yeume/skellyyeume/README.md

# **skellyyeume**
This is a guide on how to hardwire build a TBK skeletyl <br>

https://bastardkb.com/product/skeletyl-kit/
https://github.com/Bastardkb/Skeletyl/tree/main?tab=readme-ov-file

# Table of Contents
1. [Rules](#rules)
2. [Useful Links](#usefullinks)
3. [Prerequisites & things to download](#prereq)
4. [BOM (Bill of materials)](#bom)
5. [How does handwiring keyboard work?](#howthehell)
6. [What are all these files in the firmware folder?](#whatthehell)
7. [Getting the firmware onto the microcontroller](#buildfirmware)
8. [Wiring up the board](#wiring)
8. [Assembling the case](#finalassembly)
9. [Okay I wired everything, but it doesn't work...](#debug)
10. [Future...](#todo)

<br>

___

<br>

<div id='rules'>

# Rules

- NEVER unplug the TRRS jack from either half of the keyboard while it is plugged in via usb to the computer.
- ALWAYS flash the firmware to both microcontrollers when making changes.

<br>

___

<br>

<div id='usefullinks'>

# Useful Links 
https://docs.qmk.fm/features/split_keyboard<br>
https://docs.splitkb.com/troubleshooting/one-half<br>
https://docs.qmk.fm/keycodes_basic<br>
https://docs.qmk.fm/feature_layers<br>
https://docs.qmk.fm/mod_tap (if you want to use [**homerow mods**](https://precondition.github.io/home-row-mods))

<br>

___

<br>

# Disclaimer: 
- You do not need any prior programming background, but it helps.
- This guide assumes you have some experience with soldering.
- keymapping in vial is ready! check the firmware folder. 
- The default bootmagic button for putting your microcontroller in DFU mode after the first successful flash is 0,0 on each half (your Q key for the left half and Y key for the right half -- you simply need to hold the button down while connecting the half of the keyboard via usb)
- The vial secure unlock buttons are 0,0 and 0,1 (Q and W key on the keyboard)

<br>

___

<br>

<div id='prereq'>

# Prerequisites & things to download:

- It is **highly** recommended to watch Joe scotto's vid, https://youtu.be/hjml-K-pV4E?t=41&feature=shared. Yes it is 20 minutes long, but it goes over very important fundamnetals and techniques that will be useful for completing this build.

- [QMK MSYS](https://msys.qmk.fm) <details>
<collapse> </collapse>
This is the CLI (Command Line Interface, think of it like the command prompt/power shell on windows (or if you're a mac user, the terminal), but it comes with lots of prebuilt tools, and also has Git preinstalled so you don't need to go through manually setting up Git on your machine). Install it wherever you like, as long as you can find it later.
</details>

- [VS Code](https://code.visualstudio.com/download)<details>
<collapse> </collapse>
Text editor of choice, you'll use this to modify the keymap later when building the firmware.
</details>

<br>

___

<br>

<div id='bom'>

# BOM:
- Case/Plate <details>
<collapse> </collapse>
if you have a 3d printer, feel free to use the files
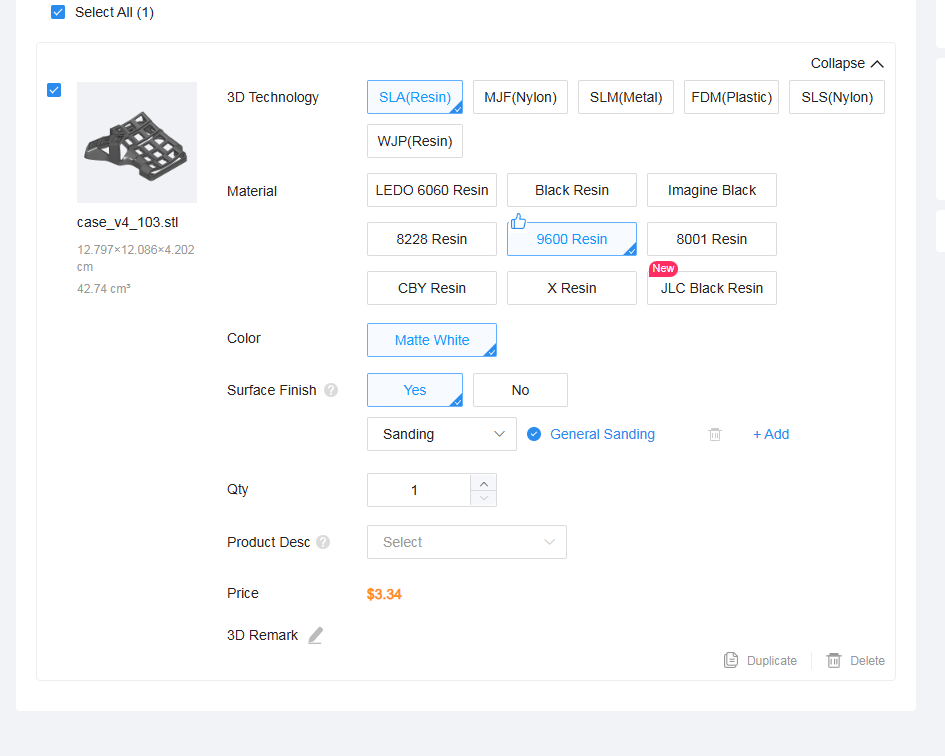
[picture p1: pictures/jlc_order_option.png]
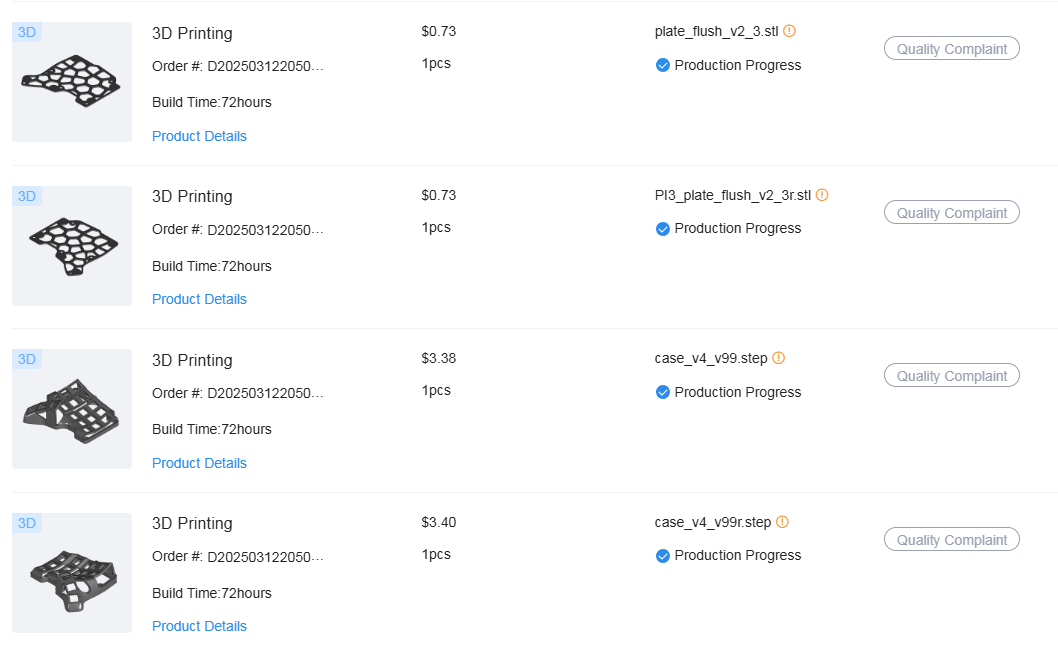
[picture p2: pictures/jlc_order_history.png]
[case](https://github.com/Bastardkb/Skeletyl/blob/main/V4/case_v4_103.stl) , [plate](https://github.com/Bastardkb/Skeletyl/blob/main/V4/plates/plate_v4_103.stl) and print them yourself. I personally went with https://jlc3dp.com and chose their 9600 Resin option. You can see it doesn't cost a lot. The part that costs the most is the shipping, as this company is located in Hong Kong (for me it was ~20 dollar shipping.)  
</details> 

- [Pro Micro](https://www.amazon.com/dp/B0D83FBYPD?ref=ppx_yo2ov_dt_b_fed_asin_title)
- [TRRS cable (if you don't have one)](https://www.amazon.com/Auxiliary-Braided-Compatible-Stereos-Headphones/dp/B07PJW6RQ7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)
- [TRRS jack](https://www.amazon.com/uxcell-Connector-Female-Socket-PJ-320A/dp/B07KXZ6T3D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)
- [[OPTIONAL] 16 gauge copper wire](https://www.amazon.com/dp/B000BP7WH8?ref=ppx_yo2ov_dt_b_fed_asin_title) - This is to provide a cleaner way to wire up the columns/rows, but it can be done without.
- [22AWG wire](https://www.amazon.com/dp/B00QTCBZ4I?ref=ppx_yo2ov_dt_b_fed_asin_title)
- [1N4148 diodes](https://www.amazon.com/BOJACK-Switching-IN4148-Electronic-Silicon/dp/B07Q4F3Y5W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)
- [M4 screw insert](https://www.amazon.com/Threaded-Inserts-Plastic-Assortment-Printing/dp/B0DFGRCD33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)
- [M4 flathead screw](https://www.amazon.com/HanTof-Countersunk-Machine-Wrenches-Threaded/dp/B0B9HXP7DJ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)
- [solder iron](https://www.amazon.com/dp/B06XZ31W3M?ref_=ppx_hzsearch_conn_dt_b_fed_asin_title_5&th=1)
- [solder wire](https://www.amazon.com/dp/B01M071WEE?ref=ppx_yo2ov_dt_b_fed_asin_title)
- [glue gun](https://www.amazon.com/Krightlink-Sticks-School-Crafts-Repairs/dp/B0BC878ZRG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)

<br>

___

<br>

<div id='howthehell'>

# How does handwiring keyboard work?
Imagine the keyboard as a matrix grid, like tic-tac-toe. As every switch has 2 metal pins, a collection of one of the pins on each switch can be wired together to form columns, and the other pin can be used for rows. Each row and column is designated to a pin on the microcontroller, and based on a switch press on the grid, the keyboard recognizes the keystroke to the designated key command.

<br>

___

<br>

<div id='whatthehell'>

# What are all these files in the firmware folder?
I've went ahead and dropped comments where I could, and also made [an explanation file of keyboard.json](keyboard.json_explanation.yaml), but these are the most important files. If you're curious about each line by line, you can google them easily by querying something like `soft_serial_pin qmk`.:
- keyboard.json - sets up the basic information about your keyboard (keyboard matrix layout, what sort of microcontroller is used, what pins on the microcontroller are used, etc.)
- keymap.c - contains different keymap profiles/layouts based on what tools you'll be using (ex. via). This is the file that you want to modify if you want custom keymapping.
- config.h, rules.mk - similar to keyboard.json, but has additional settings.

<br>

___

<br>

<div id='buildfirmware'>

# Getting the firmware onto the microcontroller

1. Open QMK MSYS, and input `qmk setup`. This process will take some time depending on your internet connection. It basically prepares your machine with necessary tools to start building your firmware, and clones the [qmk_firmware github repo](https://github.com/qmk/qmk_firmware) on to your machine.
2. Once the setup has finished, copy the [hex file](firmware/handwired_skellyyeume_vial.hex) from the firmware folder to the root of the `qmk_firmware` folder.
3. Type the following in QMK MSYS
```
cd qmk_firmware
```

```
qmk flash -bl avrdude handwired_skellyyeume_vial.hex
```

<br>
If you're building your firmware, expand below:
<collapse><details>
If you want to compile the qmk default keymapping, run 
```qmk compile -kb handwired/skellyyeume -km default```

<br>

If you want to compile the vial keymapping, you'll have to clone the [vial-qmk repo](https://github.com/vial-kb/vial-qmk.git) on to your machine, and copy the `skellyyeume` folder inside  the firmware folder of this project into your vial-qmk folder's '/keyboards/handwired' directory.
then run
```
make handwired/skellyyeume:vial
```

<br>

once successfully compiled, you should see a message like the following and find the file that was generated at the root of the qmk_firmware folder:
![img](pictures/compile.png)

If for any reason you need to flash the qmk default firmware... run

```
qmk flash -bl avrdude handwired_skellyyeume_default.hex
```

</details></collapse>

<br> 

otherwise continue...

![img](pictures/flash1.png) <br>
You'll first be prompted to put the microcontroller in DFU/bootloarder mode to flash the firmware. You can achieve this by briefly touching the RST & GND Pin on the microcontroller with some tweezers. Please see the [pinout](pictures/pinout.jpg). It only takes a gentle tap on the pins and you'll see a very tiny red led light up for half of a second when you short these pins. Wait for 5~10 seconds and then biggerf red LEDs will flash and you'll see more console lines printed on QMK MSYS console like below. <br>
![img](pictures/flash2.png)

<h1 style="color: red; font-weight: bold"> Repeat the process for a second microcontroller, which will be used for the other half of the keyboard. </h1>

<br>

___

<br>

<div id='wiring'>

# Wiring up the board (FINALLY)
Here are some rough pictures on what it will eventually look like ![left half](pictures/left.jpg), ![right half](pictures/right.jpg)

The following is the exact wiring diagram based on my board. Please pay close attention as column-to-microcontroller connections are mirrored between the halves.

 ![alt text](<pictures/wire diagram.png>)
 ![alt text](<pictures/TRRS wiring guide.jpg>)

1. I first inserted the switches into the case. Note the orientation of the switches. While it is not required to do the exact same, I found this to be the easiest for soldering purposes. <details><collapse>
![alt text](pictures/switchesOnly1.png)
![alt text](pictures/switchesOnly2.png)
</collapse></details>
2. Prepare 24 sleeved wires cut up to roughly 3 - 4 inches in length. Each end of the wire must be degloved (1/8 - 1/4 inch) so that they can be soldered. In addition, prepare the copper wires for the row/columns accordingly (if you're using them).<br>
&nbsp;&nbsp; * If you end up using copper wires, try your best to make it as flush as possible with the case so that they don't get in the way when you have to put in the M4 screw inserts into the case later. *
3. I soldered the columns first since they're the easiest, then the diodes (please refer to pro tip on getting the diode on the switch pin below under "callouts" section), and then finally the rows. **NOTE** The direction of the diode is **EXTREMELY** important here. In the firmware creation step above, we specified `COL2ROW` in our keyboard.json, this means that our cathode (black line) is oriented toward the row wire. <details><collapse>
![alt text](pictures/wireWithoutMCU.png)
</collapse></details>
4. Do the same for the other half of the keyboard.
5. Now for the messy part, using the sleeved wire bits from earlier, solder each pin to the corresponding column/row as specified in the wire diagram above. In addition, connect the TRRS jack wires as well.
6. If everything has been wired correctly, you can connect the halves first using the TRRS cable and then connect the left half keyboard to the computer.

## Few callouts:
- Inevitably, there will be parts of the row wire where it will touch the column wire. In order to prevent shorting out the connection, you must wrap a non-conductive material (ex. shrink tubing or electrical tape) on the contact points. Refer to the images above for reference.
- When connecting the row/column wires to the microcontroller, it doesn't matter which end or what part of the row/column wire you solder to.
- If you're a keen observer, you probably asked yourself "why did this guy connect B3 pin to the second row and B2 pin to the third row?". It was a careless mistake, but it can be easily fixed where you solder B2 pin to the third row and B3 pin to the second row, but then you have to modify the order of row pins in [keyboard.json](firmware/skellyyeume/keyboard.json) so that `["B1", "B2", "B3", "B6"]` is now `["B1", "B3", "B2", "B6"]`
- Pro tip for wiring the diodes on to the switch pin <details><collapse>
You can curl the end of the diode without the black line, snip the extra wire past the loop, place it on to the switch pin, and then solder it in place. 
![alt text](pictures/diode1.png)
![alt text](pictures/diode2.png)
![alt text](pictures/diode3.png)
</collapse></details>

<div id='finalassembly'>

# Assembling the case 
1. Heat up your solder iron, and grab the M4 screw inserts and place them gently in the 4 holes in each half of the board (marked in blue in the picture below). Note, the unused 2 holes on the case are for the ["splinktegrated"](https://github.com/Bastardkb/Splinktegrated) which I have opted out of for this build.<details><collapse>
![alt text](pictures/insertSeated.jpg)
![alt text](pictures/sunk3.jpg)
</collapse></details>
2. With the solder iron, firmly but gently press down on the insert slowly (be careful not to press too hard or it could damage the case) until it is seated flush with the case. As you can  see, the insert is a bit longer than the mounting hole in the case, but it's still doable. <details><collapse>
![alt text](pictures/sunk1.jpg)
![alt text](pictures/sunk2.jpg)
</collapse></details>
3. Once finished it should look something like 
![alt text](pictures/assembled.jpg)

<div id='debug'>

# Okay I wired everything, but it doesn't work...
- the left half of the keyboard won't turn on
<br>&nbsp;&nbsp; - is the USB plugged in all the way? Try a different port on the computer? Try to connect to a different machine?
- the left half of the keyboard turns on, but the right half won't
<br>&nbsp;&nbsp; - check the VCC pins on both microcontrollers to make sure that the solder or the wire hasn't come off or something. There is a chance that you have a bad TRRS jack (hopefully not), but if you do, you'll need a voltmeter to test for continuity on each of the TRRS jack pins.
- both halves turn on, but the right side keypress isn't being registered
<br>&nbsp;&nbsp; - make sure you haven't modified [keyboard.json](firmware/skellyyeume/keyboard.json) or [config.h](firmware/skellyyeume/config.h) and that the correct pins (`D0` is what we've specified to in our firmware file) are soldered (on both the microcontroller and TRRS jack) as per the wiring diagrams above.
- both halves turn on, the keystrokes register, but they're flipped (pressing where A would normally be registers G)
<br>&nbsp;&nbsp; - check the wiring diagram to make sure your columns are wired up correctly. If you're facing an issue where pressing Q registers Z or something, check your rows.
- both halves turn on, the keystrokes register, but there are multiple being registered at once (ex. pressing J hits both J and space bar)
<br>&nbsp;&nbsp; - check that no bare wires are touching each other around the switch in question and also on the microcontroller.

<div id='todo'>

# TODO
- get via working (custom layout json maybe)
- vial support? (maybe...)
