yeume/skellyyeume/pictures/diode1.png

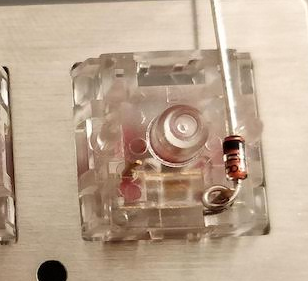
pictures/diode1.png
