yeume/skellyyeume/pictures/diode2.png

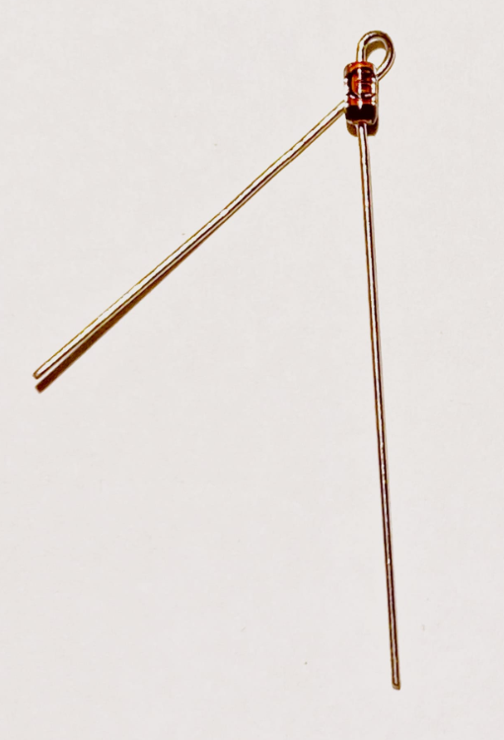
pictures/diode2.png
