yeume/skellyyeume/pictures/diode3.png

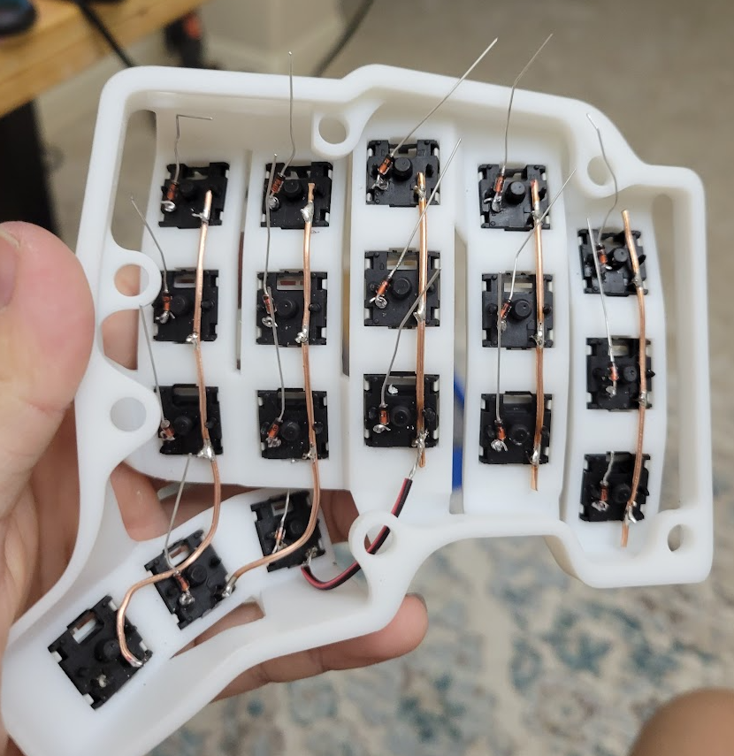
pictures/diode3.png
