yeume/skellyyeume/pictures/flash2.png

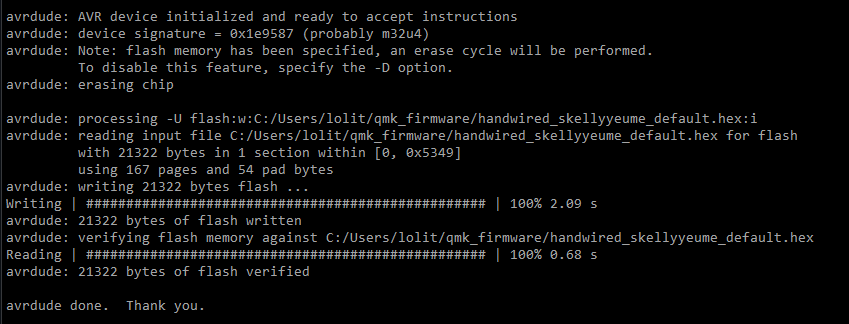
pictures/flash2.png
