yeume/skellyyeume/pictures/insertSeated.jpg

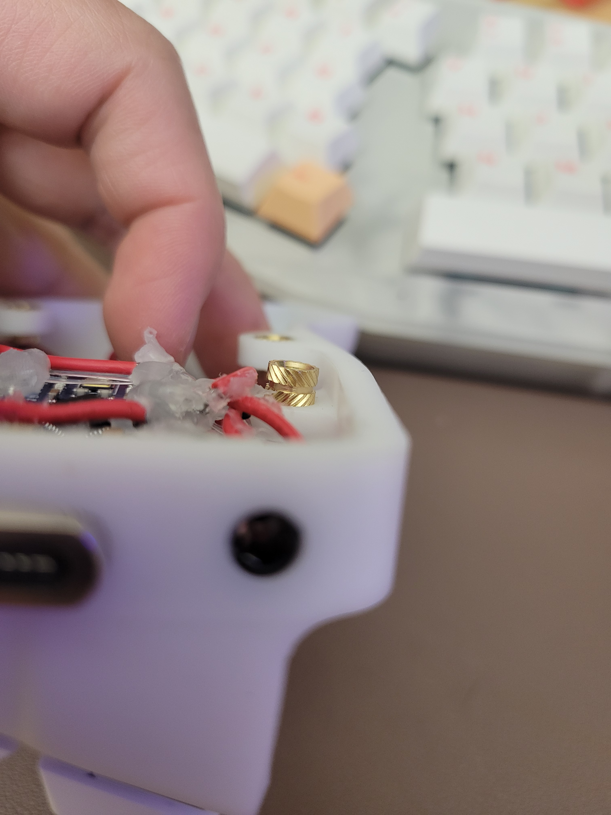
pictures/insertSeated.jpg
