yeume/skellyyeume/pictures/left.jpg

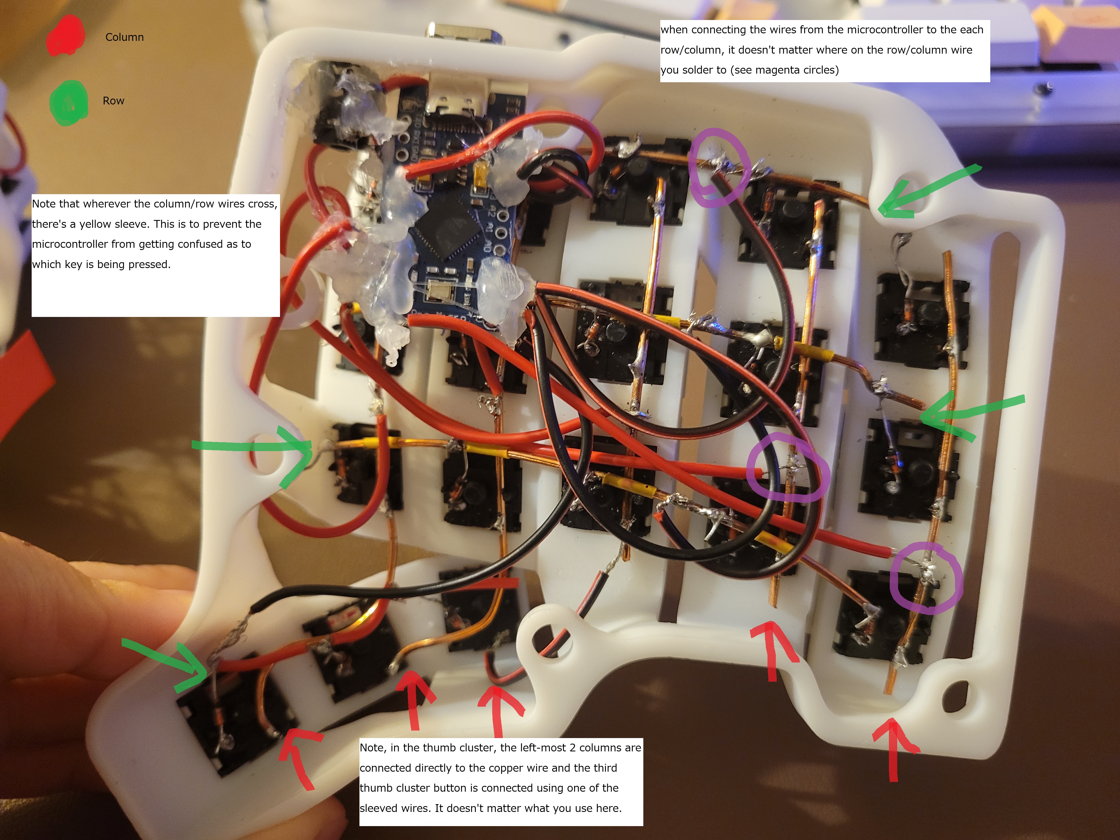
pictures/left.jpg
