yeume/skellyyeume/pictures/right.jpg

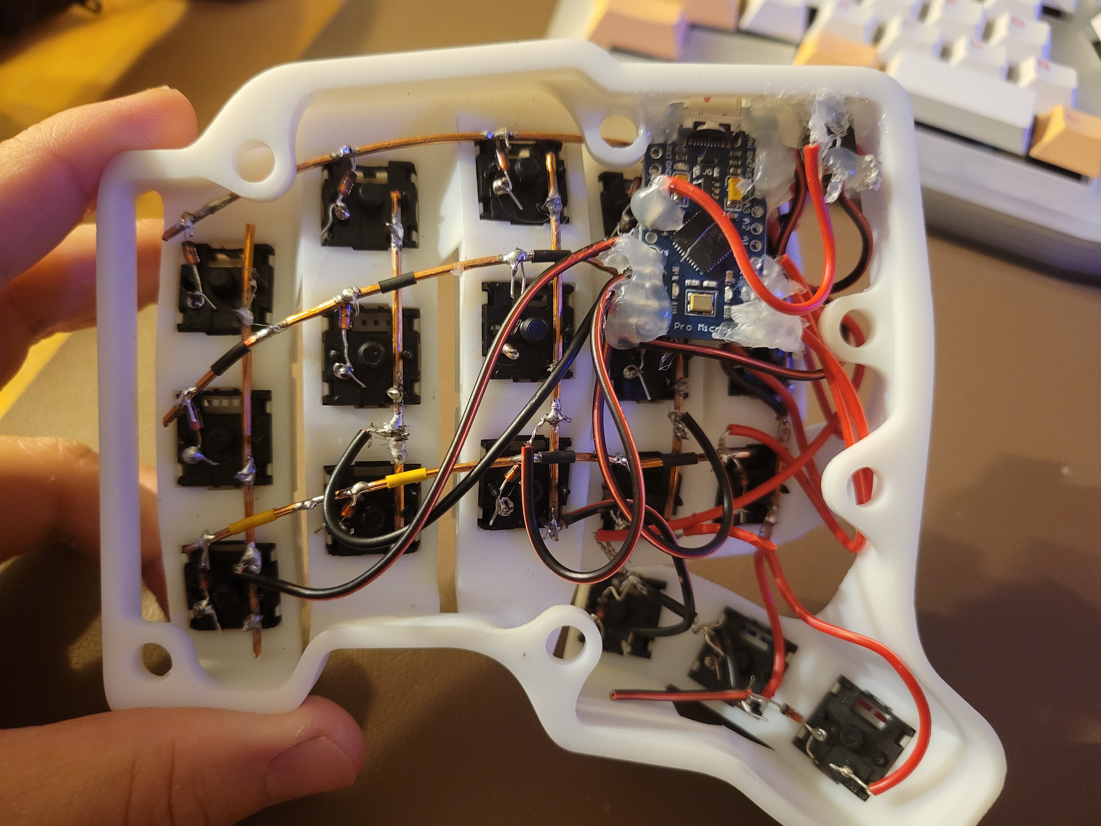
pictures/right.jpg
