yeume/skellyyeume/pictures/sunk1.jpg

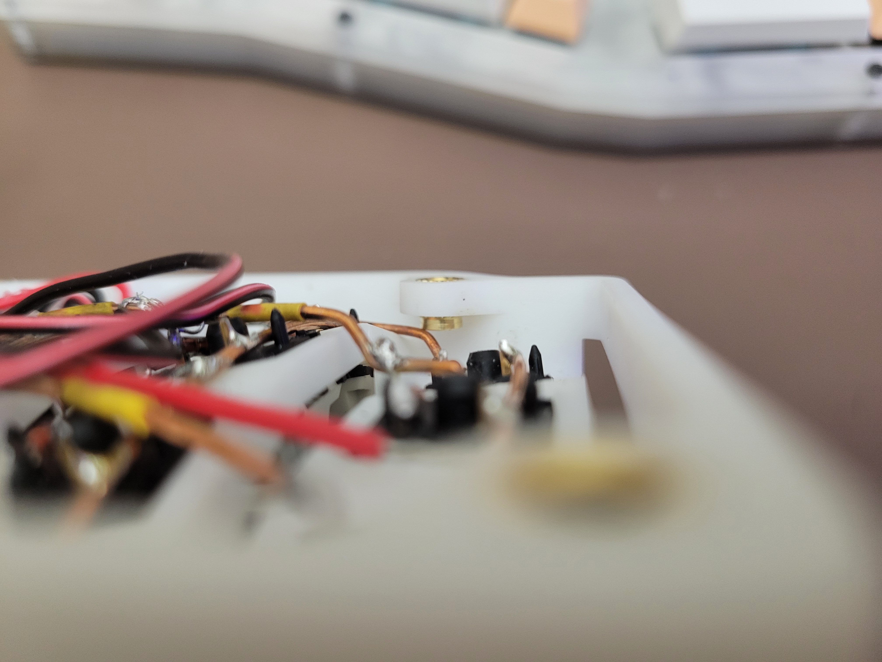
pictures/sunk1.jpg
