yeume/skellyyeume/pictures/sunk2.jpg

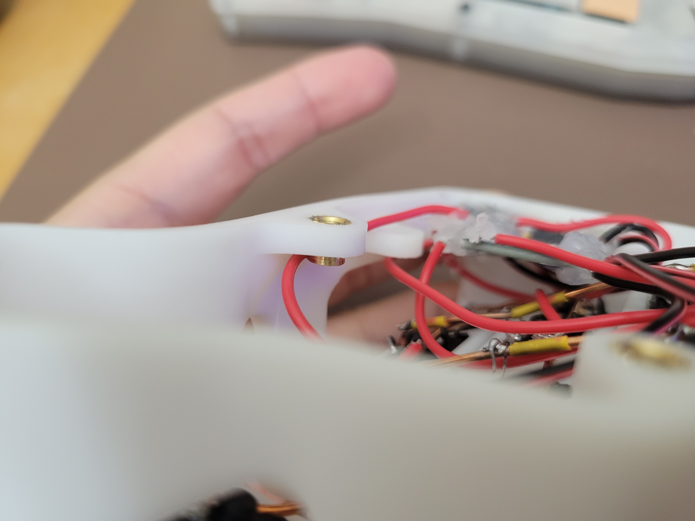
pictures/sunk2.jpg
