yeume/skellyyeume/pictures/sunk3.jpg

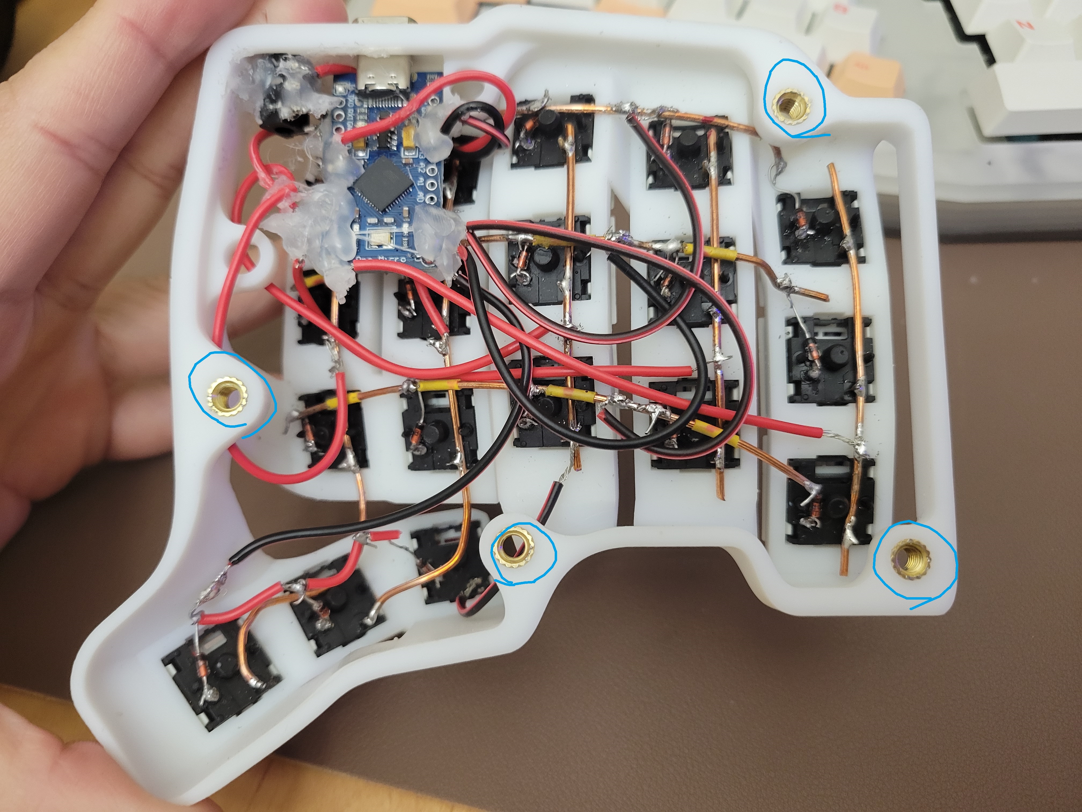
pictures/sunk3.jpg
