yeume/skellyyeume/pictures/switchesOnly1.png

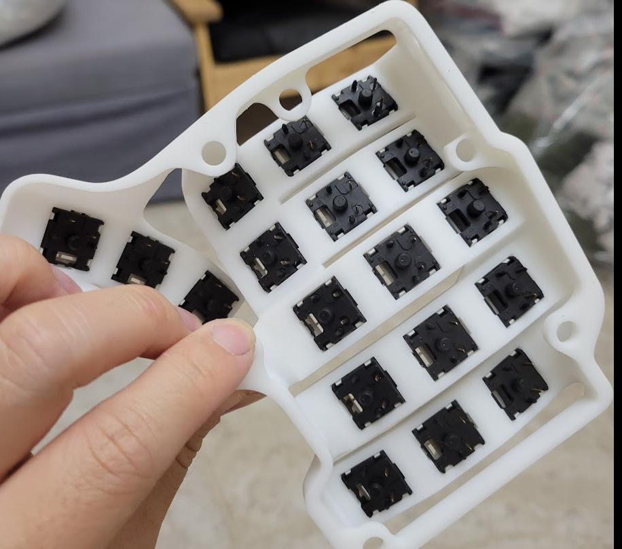
pictures/switchesOnly1.png
