yeume/skellyyeume/pictures/switchesOnly2.png

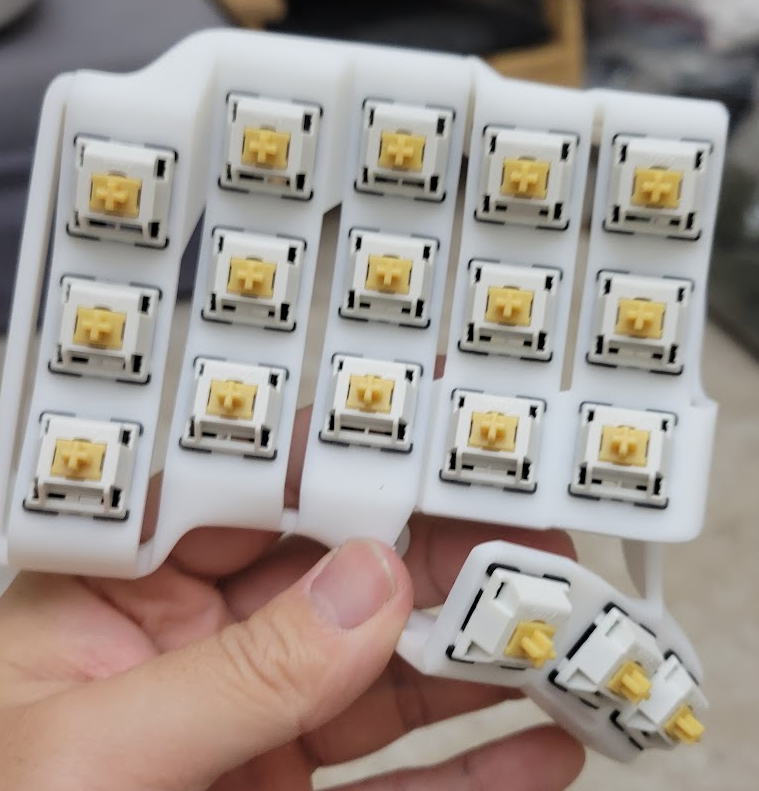
pictures/switchesOnly2.png
