yeume/skellyyeume/pictures/wire diagram.png

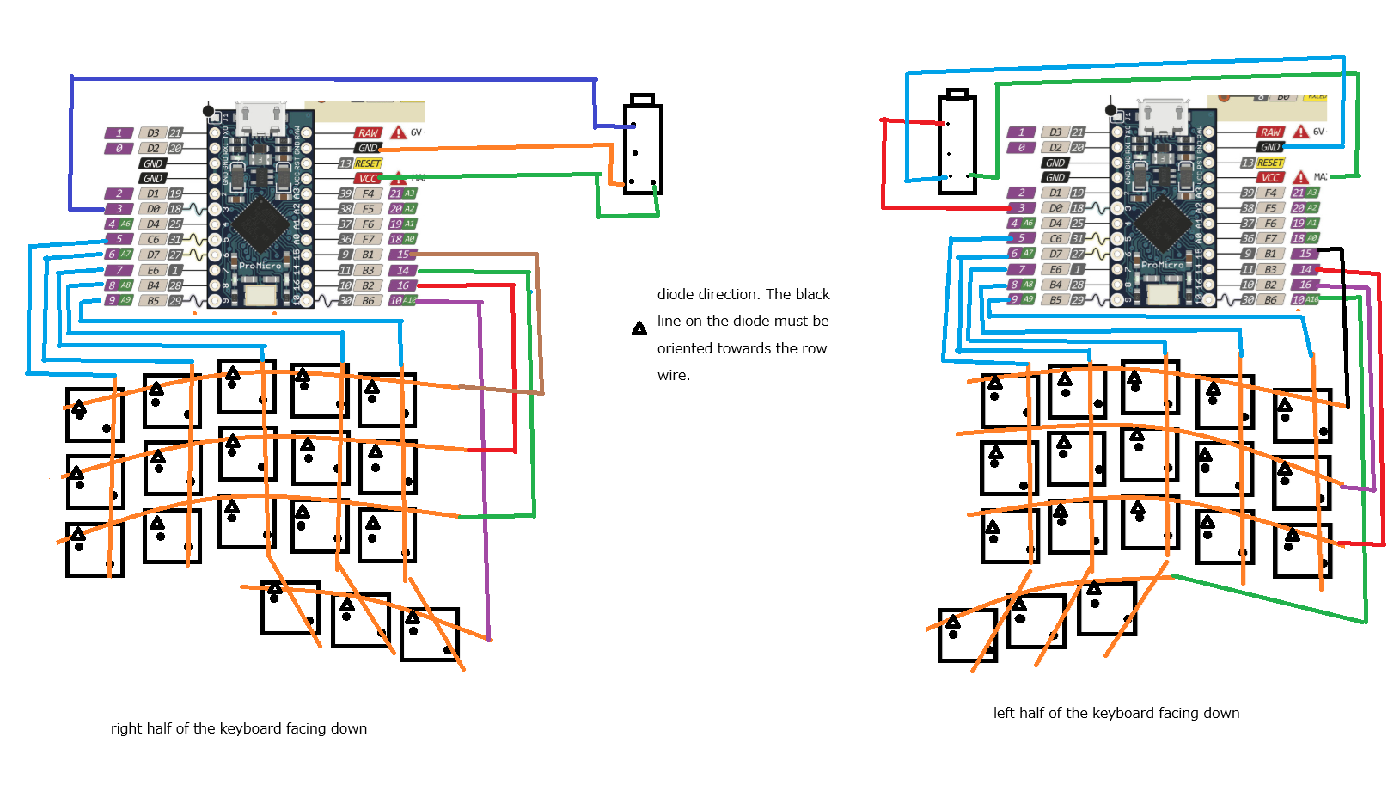
pictures/wire diagram.png
