yeume/skellyyeume/pictures/wireWithoutMCU.png

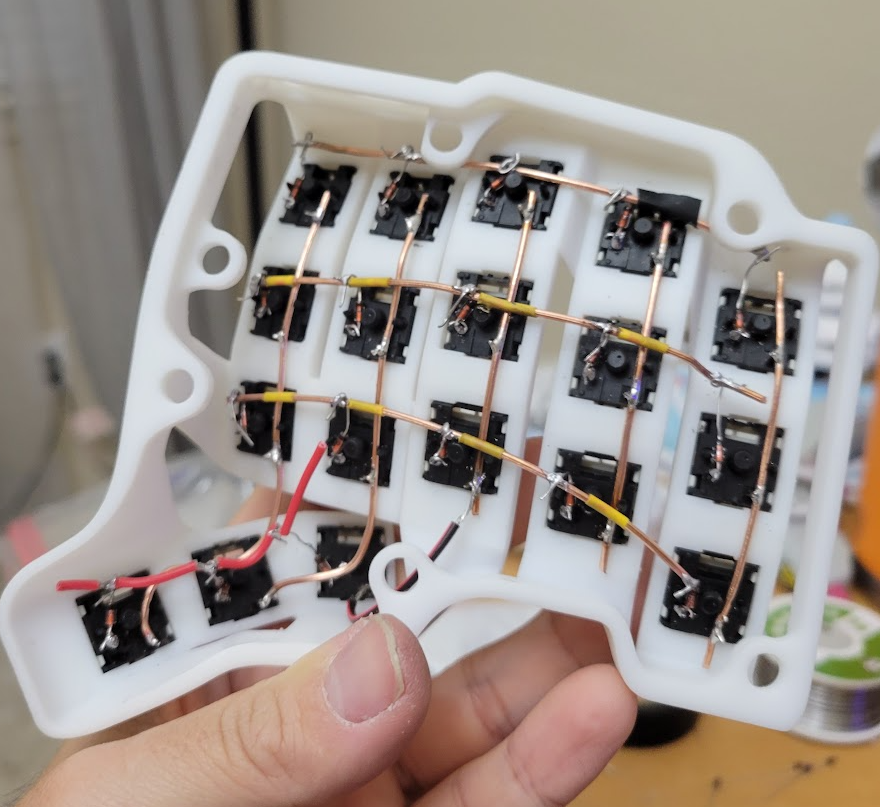
pictures/wireWithoutMCU.png
