yeume/skellyyeume/pictures/assembled.jpg

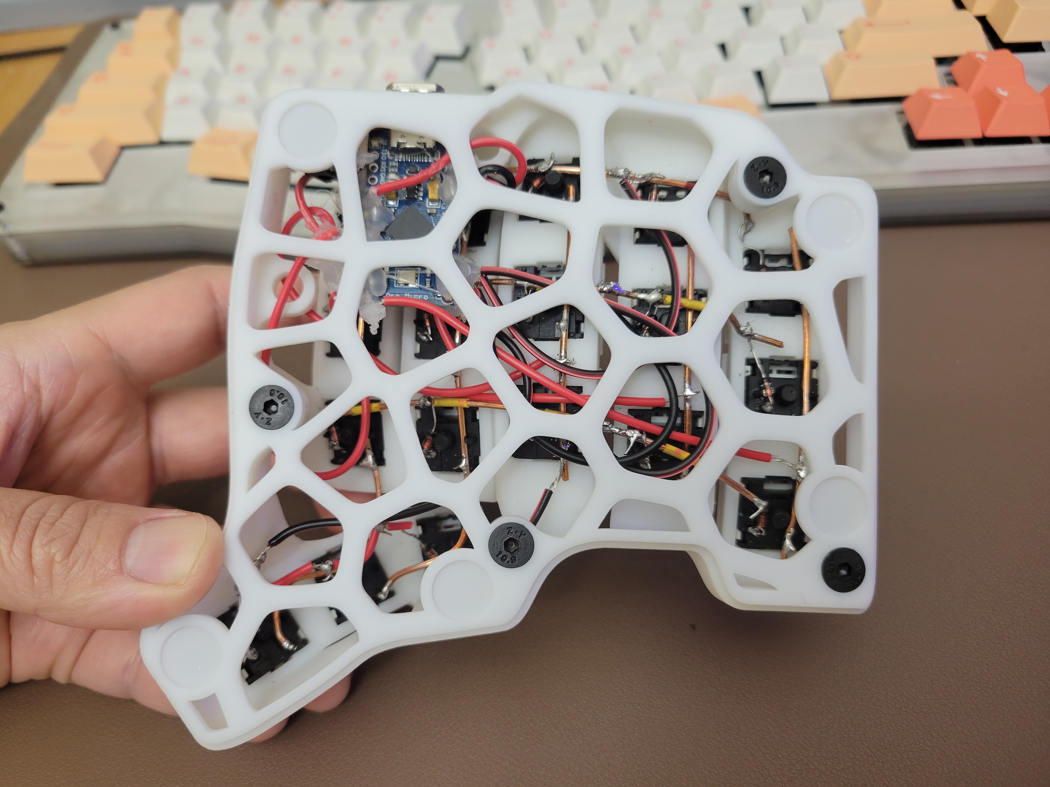
pictures/assembled.jpg
