yeume/skellyyeume/pictures/TRRS wiring guide.jpg

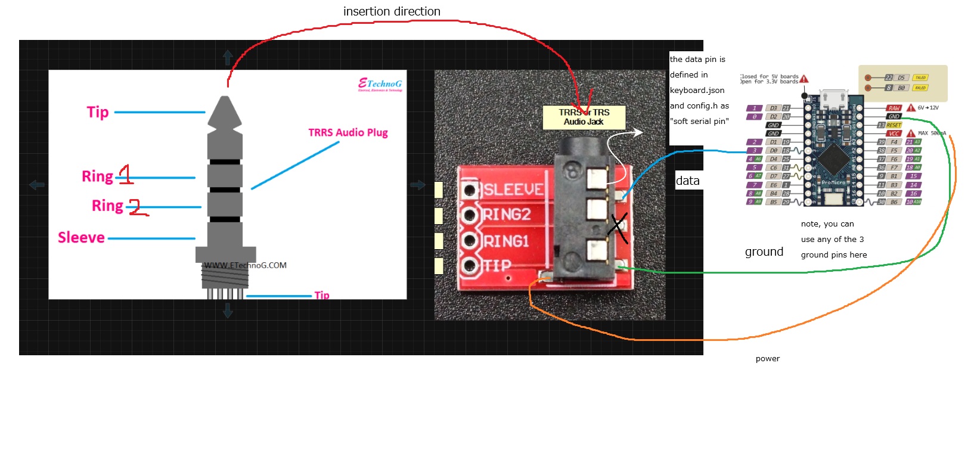
pictures/TRRS wiring guide.jpg
