yeume/skellyyeume/(commit log)

2025-04-04 update more notes, added section for case assembly
2025-04-04 add case assembly to table of contents
